evolvereaustralia/mini-dash/hardware/datasheets/waveshare-4.3c/display-back-photo-2026-11-09.png

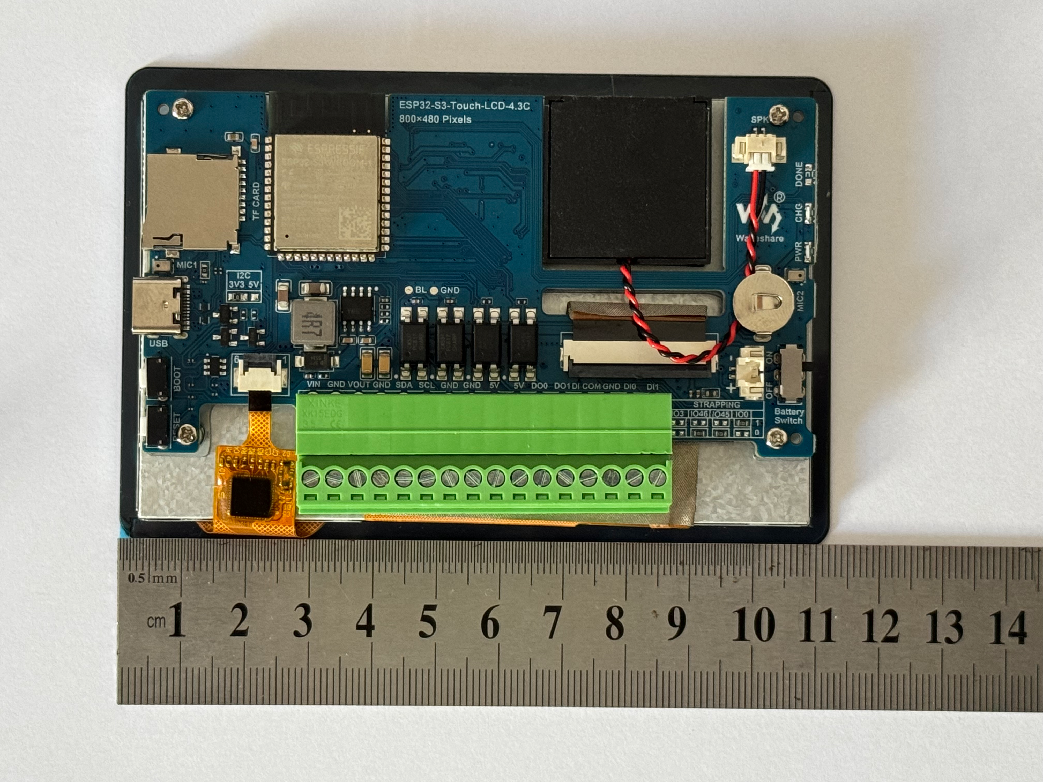
hardware/datasheets/waveshare-4.3c/display-back-photo-2026-11-09.png
