evolvereaustralia/mini-dash/hardware/enclosure/display-back-layout-check.png

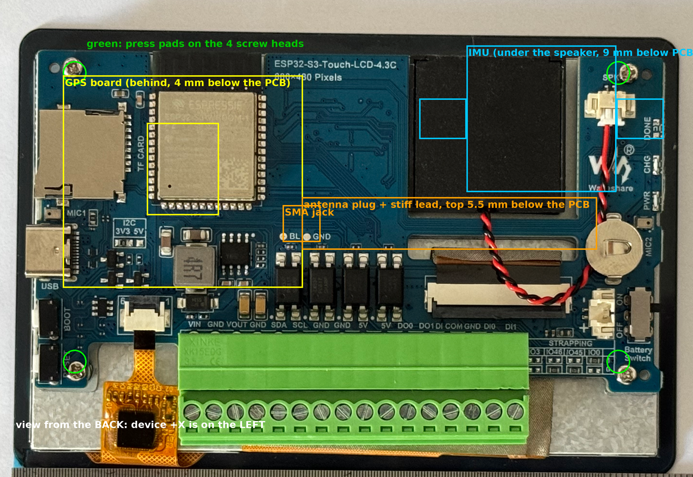
hardware/enclosure/display-back-layout-check.png
