evolvereaustralia/mini-dash/hardware/enclosure/mini-dash-layout-1-tray.png

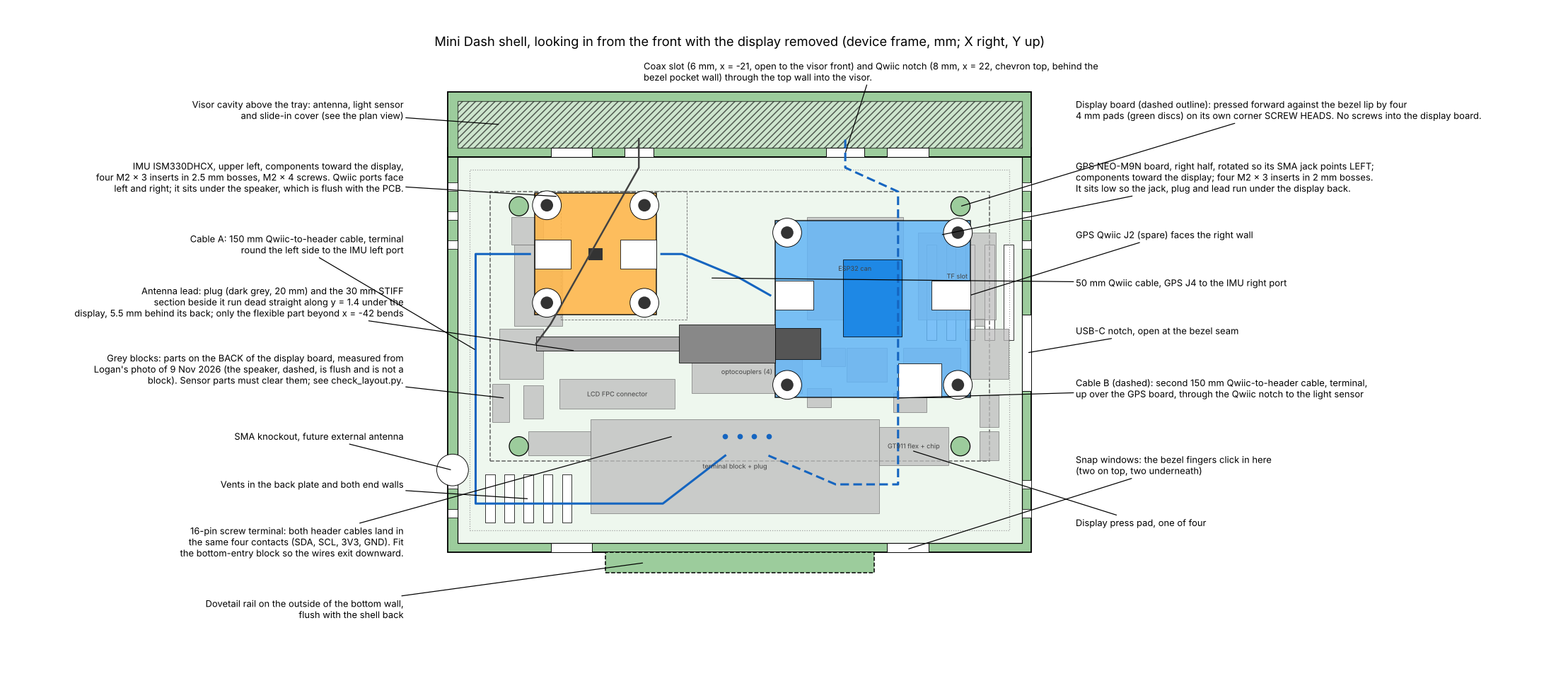
hardware/enclosure/mini-dash-layout-1-tray.png
