evolvereaustralia/mini-dash/hardware/enclosure/mini-dash-layout-2-visor.png

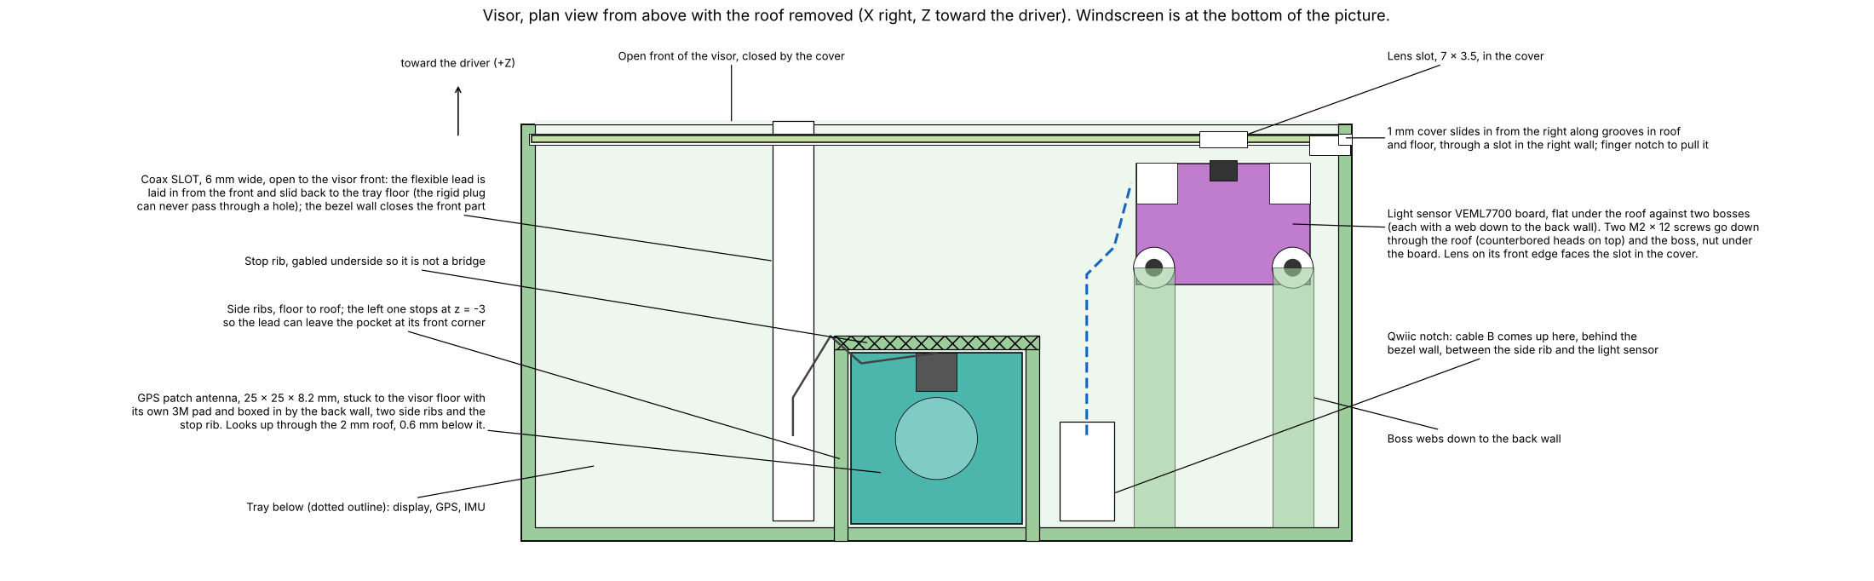
hardware/enclosure/mini-dash-layout-2-visor.png
