evolvereaustralia/mini-dash/hardware/enclosure/mini-dash-layout-3-sections.png

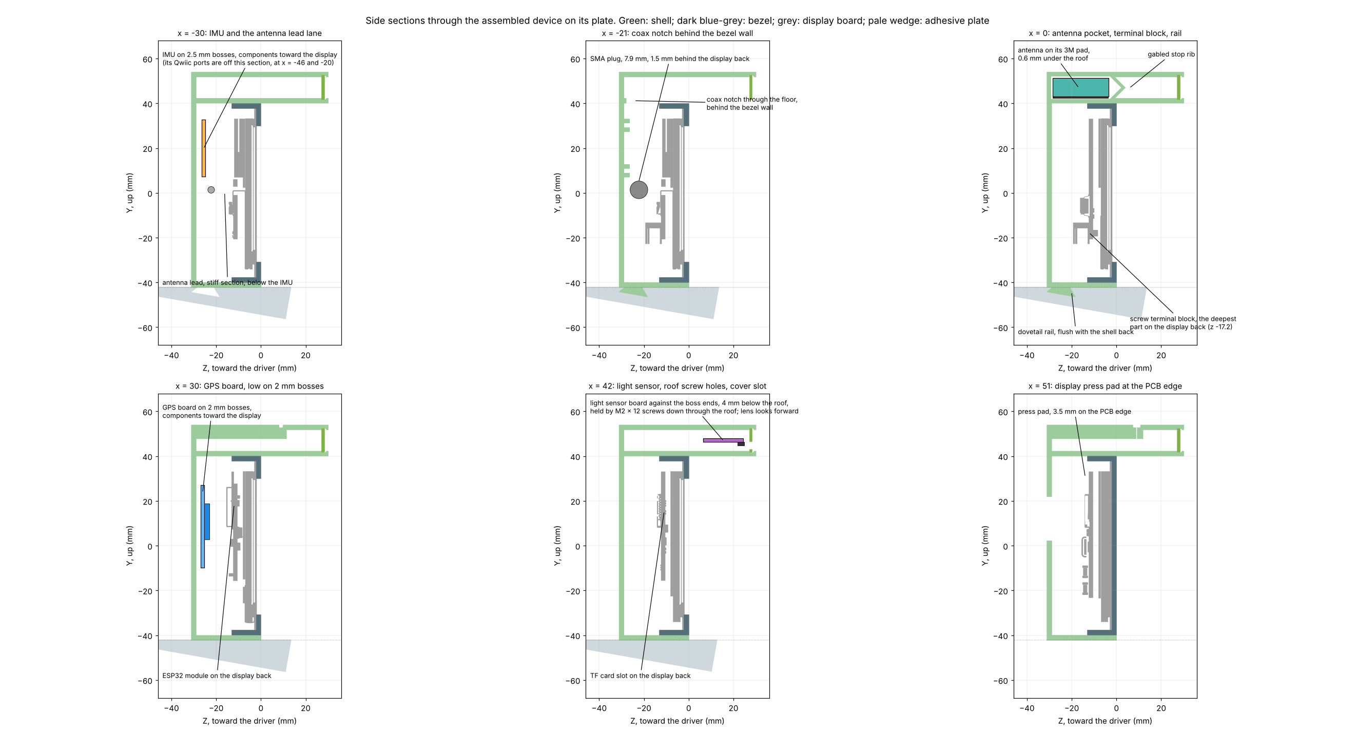
hardware/enclosure/mini-dash-layout-3-sections.png
