evolvereaustralia/mini-dash/hardware/enclosure/mini-dash-layout-4-exploded.png

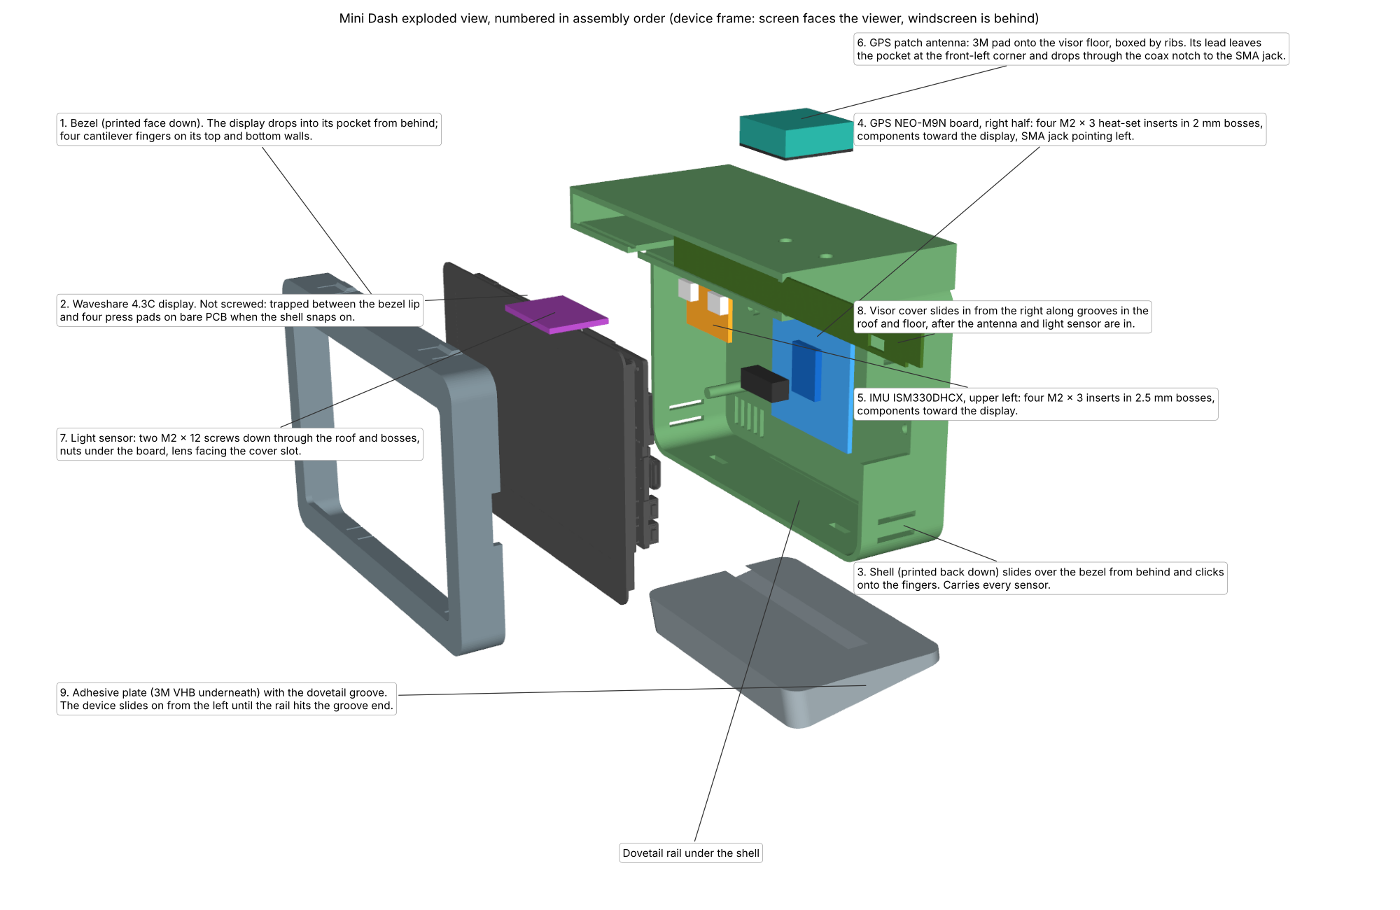
hardware/enclosure/mini-dash-layout-4-exploded.png
