evolvereaustralia/mini-dash/docs/bom.md

# Bill of materials

Status as of 24 Oct 2026. Prices AUD where known. Core Electronics unless noted.

| Item | Part | Qty | Status |
|---|---|---|---|
| Main board | Waveshare ESP32-S3-Touch-LCD-4.3C, standard, SKU 33799 | 1 | in hand |
| GPS | SparkFun GPS Breakout NEO-M9N, SMA, Qwiic (GPS-17285) | 1 | in hand |
| GPS antenna | SparkFun Antenna GPS Embedded SMA (GPS-00177) | 1 | in hand |
| IMU | SparkFun 6DoF IMU ISM330DHCX, Qwiic, 1 x 1 inch (SEN-19764) | 1 | in hand |
| Light sensor | Adafruit Right Angle VEML7700, STEMMA QT (ADA5378) | 1 | in hand |
| Qwiic cables 50 mm | Adafruit ADA4399 | 3 (1 used, 2 spare) | in hand |
| Qwiic to male header, 150 mm | Adafruit ADA4209 | 2 (1 in hand) | 2 more in the Core Electronics cart (one spare), $3.90 |
| Heat-set insert kit | Core Electronics CE10192 (M2 to M6; M2 x 3 on the GPS and IMU, 8 off) | 1 | in hand |
| Screws | Hilitchi 250-piece M2 stainless hex socket button head kit (8 x M2 x 4 for GPS and IMU, 2 x M2 x 12 plus 2 nuts for the light sensor) | 1 kit | in the Amazon AU cart, $22.99 |
| OBD dongle | Vgate vLinker BM+ BLE 4.0 (Amazon AU B08BR4KY1G) | 1 | ordered 21 Oct 2026 |
| USB-C cable | UGREEN 60 W USB-C to USB-C right angle, 1 m, USB 2.0 data | 1 | in the Amazon AU cart, $12.99 |
| Dash adhesive | Genuine 3M Scotch 5952 VHB, 12 mm x 4.5 m, black | 1 | in the Amazon AU cart, $31.20 (ships from Amazon US). Test patch first; 3M 4298 promoter only if the test fails |
| Filament | Prusament PETG (or ASA), about 150 g for all four parts | | in hand |
| Fallback power | 12 V socket USB-C PD adapter, 3 A | 1 | only if the car's port sags |
