evolvereaustralia/mini-dash/hardware/enclosure/export/mini-dash-assembly.step

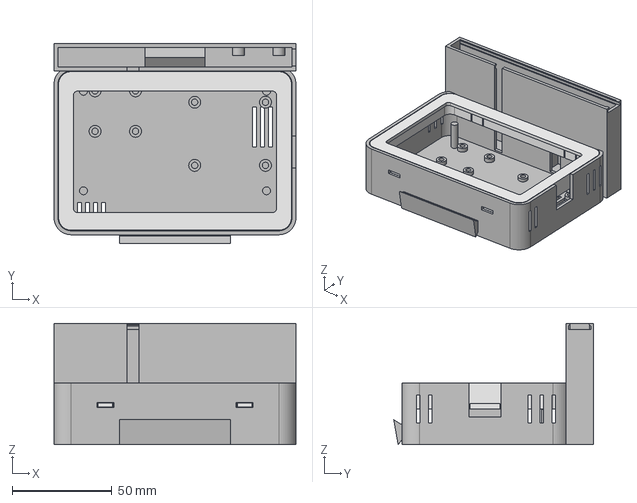
[picture p7: CAD file, 2026-11-09]
hardware/enclosure/export/mini-dash-assembly.step
121.6 x 100.3 x 61.0 mm
bezel
