evolvereaustralia/mini-dash/hardware/datasheets/ESP32-S3-Touch-LCD-4.3C-3D.stp

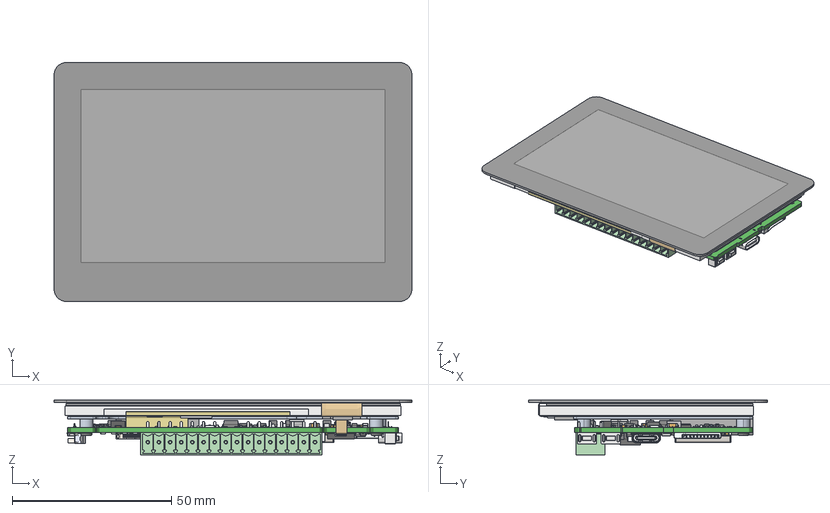
[picture p8: CAD file, 2026-10-24]
hardware/datasheets/ESP32-S3-Touch-LCD-4.3C-3D.stp
112.4 x 75.1 x 17.2 mm
SPK-26X26X4_2
BOARD
SOD323 x 3
_2_1_2_3_4_AF0 x 20
_7_1_2_AF0 x 20
5_1_2_A x 40
_7_AF0 x 40
USER_LIBRARY-RES_0603-0201_1 x 32
USER_LIBRARY-RES_0603-0201_2 x 32
USER_LIBRARY-RES_0603-0201_3 x 32
USER_LIBRARY-RES_0603-0201_4 x 32
FILTER-SMD_4P-L5_0-W4_5-BL_FI_1
FILTER-SMD_4P-L5_0-W4_5-BL_FI_2
3_1_2_3_A x 8
3_1_A x 22
3_1_2_A x 23
SOT-23 x 8
SMA-5401_AF0 x 7
SOT23-5AND6_00 x 10
SOT23-5-14065_AF0 x 2
EXTRUDED-426088
EXTRUDED-426483
EXTRUDED-427438
USER_LIBRARY-0201_0603M__CAP_1 x 81
USER_LIBRARY-0201_0603M__CAP_2 x 81
USER_LIBRARY-0201_0603M__CAP_3 x 81
EXTRUDED-442852 x 3
USER_LIBRARY-SOIC-8-150_PIN_SOI x 16
USER_LIBRARY-SOIC-8-150_SOIC_15 x 2
C0201_20210301_STEP_C0201_20210 x 14
L0201_20210301_STEP_L0201_20210 x 3
C0402_20210301_STEP_C0402_20210
R0201_20210301_STEP_R0201_202_1 x 8
R0201_20210301_STEP_R0201_202_2 x 8
R0201_20210301_STEP_R0201_202_3 x 8
TRACE_1_SUBMODEL-MINI-ANT-TYPEB
DFN1006_STEP_DFN1006_STEP_SUBMO
SOP8_REV1_20210308_STEP_SOP8_RE
XTAL3225_20210301_STEP_XTAL32_1
XTAL3225_20210301_STEP_XTAL32_2
XTAL3225_20210301_STEP_XTAL32_3
XTAL3225_20210301_STEP_XTAL32_4
XTAL3225_20210301_STEP_XTAL32_5
ESP32-S3_20210301_STEP_ESP32-_1
ESP32-S3_20210301_STEP_ESP32-_2
UID__4-128_DESIGNROOTMODEL_PCB_
UID__4-129_DESIGNROOTMODEL_PCB_
UID__4-130_DESIGNROOTMODEL_PCB_
UID__4-149_DESIGNROOTMODEL_PCB_
UID__4-150_DESIGNROOTMODEL_PCB_
UID__4-151_DESIGNROOTMODEL_PCB_
UID__4-167_DESIGNROOTMODEL_PCB_
UID__4-168_DESIGNROOTMODEL_PCB_
UID__4-169_DESIGNROOTMODEL_PCB_
UID__1-279_DESIGNROOTMODEL_PCB_
UID__1-280_DESIGNROOTMODEL_PCB_
UID__1-292_DESIGNROOTMODEL_PCB_
UID__1-298_DESIGNROOTMODEL_PCB_
UID__1-299_DESIGNROOTMODEL_PCB_
UID__1-300_DESIGNROOTMODEL_PCB_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
