evolvereaustralia/mini-dash/hardware/enclosure/export/mini-dash-shell.stl

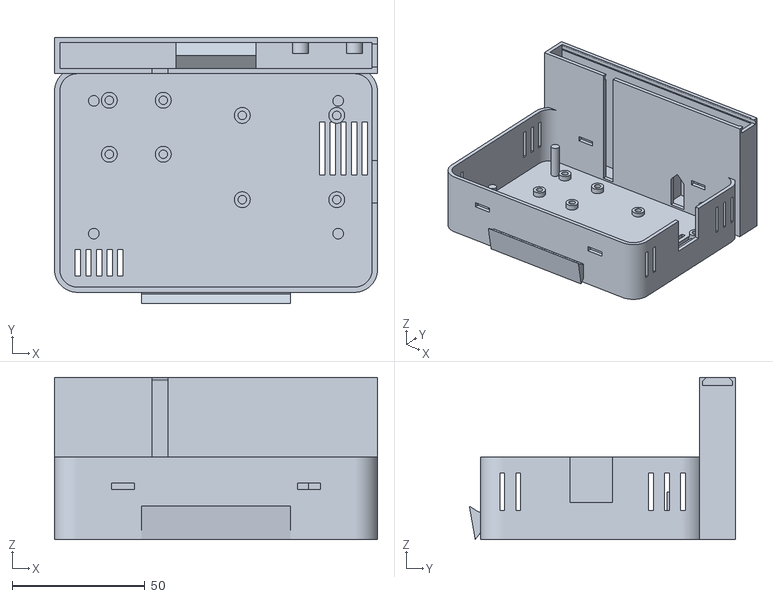
[picture p9: CAD file, 2026-11-09]
hardware/enclosure/export/mini-dash-shell.stl
121.6 x 100.3 x 61.0
