evolvereaustralia/mini-dash/hardware/enclosure/export/mini-dash-pad-coupon.stl

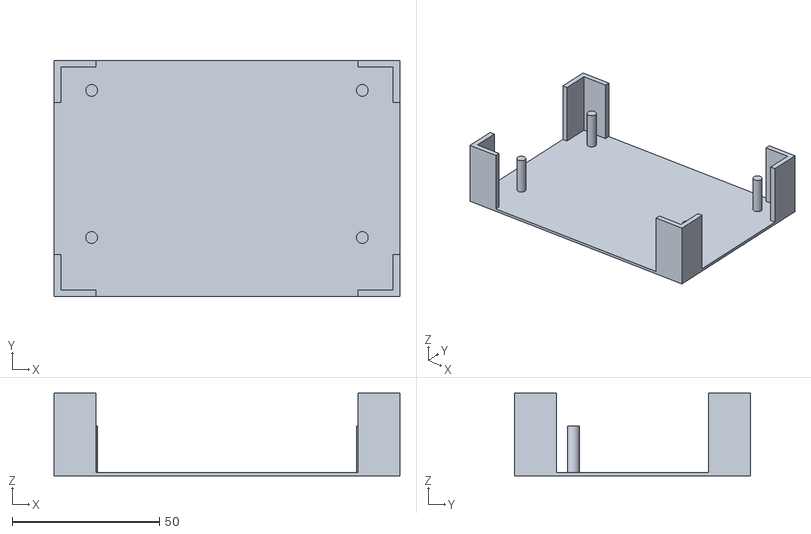
[picture p10: CAD file, 2026-11-08]
hardware/enclosure/export/mini-dash-pad-coupon.stl
117.6 x 80.3 x 28.2
