evolvereaustralia/mini-dash/hardware/enclosure/export/mini-dash-bezel.stl

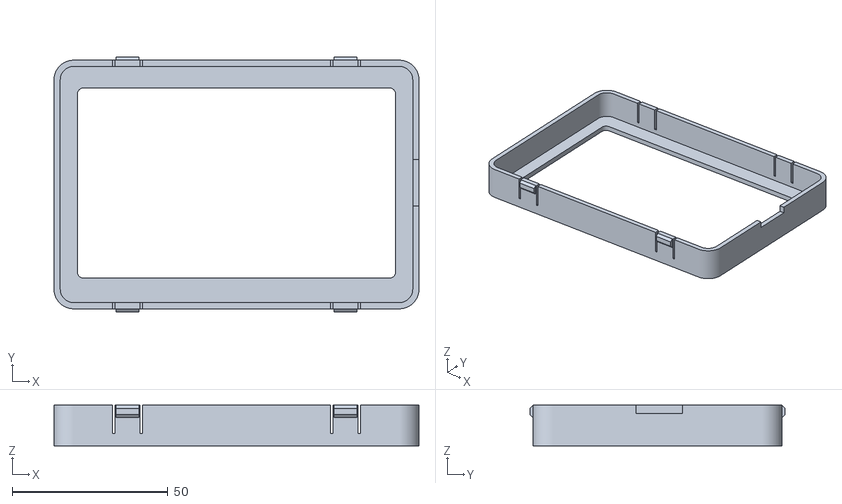
[picture p11: CAD file, 2026-11-08]
hardware/enclosure/export/mini-dash-bezel.stl
117.0 x 81.7 x 13.0
