evolvereaustralia/mini-dash/hardware/enclosure/export/mini-dash-insert-coupon.stl

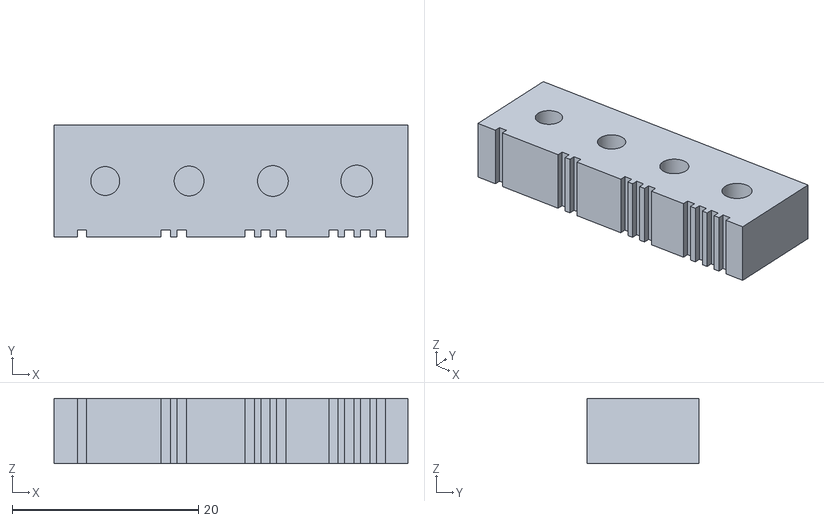
[picture p12: CAD file, 2026-10-25]
hardware/enclosure/export/mini-dash-insert-coupon.stl
38.0 x 12.0 x 7.00
