evolvereaustralia/mini-dash/hardware/enclosure/export/mini-dash-visor-cover.stl

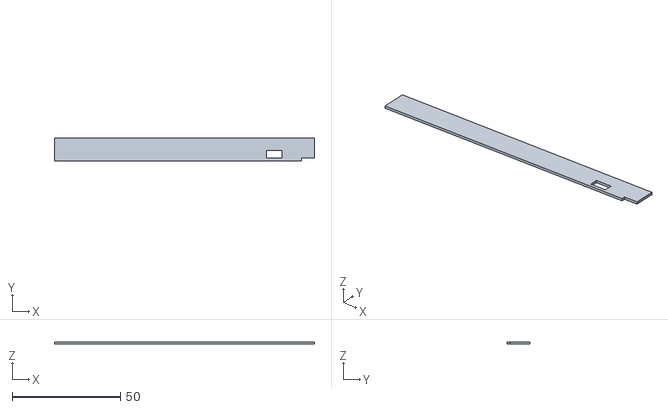
[picture p13: CAD file, 2026-10-24]
hardware/enclosure/export/mini-dash-visor-cover.stl
119.9 x 10.7 x 1.00
