evolvereaustralia/mini-dash/hardware/enclosure/export/mini-dash-plate.stl

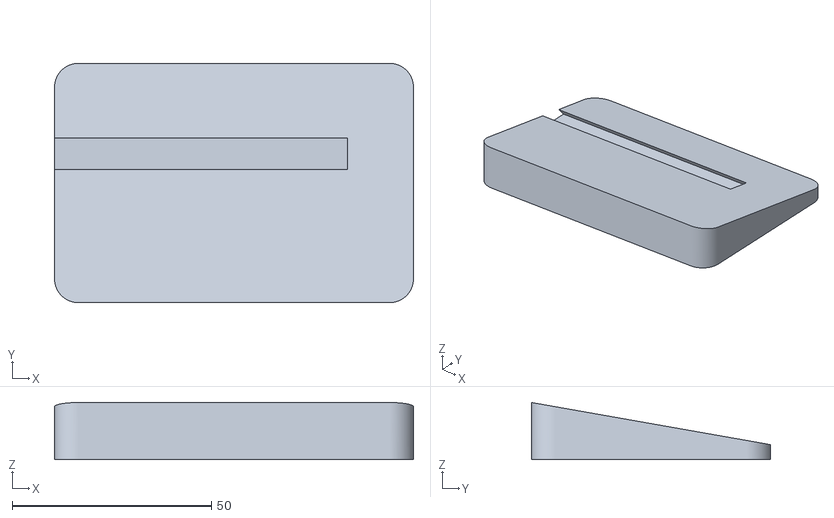
[picture p14: CAD file, 2026-10-24]
hardware/enclosure/export/mini-dash-plate.stl
90.0 x 60.0 x 14.3
