evolvereaustralia/mini-dash/(list of files, cad)

Other CAD files:
hardware/datasheets/waveshare-4.3c/ESP32-S3-Touch-LCD-4.3C-2D.dxf
