evolvereaustralia/mini-dash/docs/calibration.md

# Calibration

To be written in phase 3b. Will cover: IMU mounting calibration in Settings (stationary, level road, engine off), accelerometer bias at standstill, checking the attitude estimate against a hard stop, and the GPS speed cross-check against the speedo.
