evolvereaustralia/mini-dash/(commit log)

2026-10-24 Mini Dash: brief v2, enclosure draft 2.5, printability checker, layout drawings, datasheets
    Repo set-up for phase 2. CLAUDE.md is the single source of truth. Enclosure
    model (CadQuery) with rail-on-shell dovetail, layer-by-layer overhang check,
    four layout drawings generated from the model and Waveshare's STEP, STL/STEP
    exports, and the Waveshare and SparkFun board files the design was measured
    from. Firmware starts in phase 3a.
    Claude-Session: https://claude.ai/code/session_01TbvJXnNUeiEdX23skT3Aox
2026-10-24 BOM and adhesive: dongle already ordered, 3M VHB 5952 for the plate, carts built
    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
2026-10-24 Test log: VOUT 3.43 V pass, header cable A wired
    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
2026-10-25 Insert test coupon STL and heat-set procedure in assembly notes
    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
2026-11-05 Enclosure draft 2.6: notches behind the bezel wall, GPS right and rotated, press pads on bare PCB, roof screws for the light sensor
    - Both floor notches moved to z -22..-13.5, behind the bezel pocket wall; coax notch 10 mm at x -21, Qwiic 8 mm at x 22
    - GPS board right half, rotated 180 (SMA jack left), 2 mm bosses with M2 x 3 inserts; plug plus 30 mm stiff lead run straight along y = 4 under bare PCB
    - IMU to (-33, 22); left antenna rib stops at z -3 so the lead leaves the pocket at the front corner
    - Display bosses replaced by four 5 mm press pads on bare PCB (old ones sat on the DC terminal and standoffs, display was off-centre)
    - Light sensor: M2 x 12 through counterbored roof holes, nut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
2026-11-08 Enclosure draft 2.7: fix the 2 mm glass datum, relayout for the corrected depth
    - Device z = 0 is the bezel front face; the glass sits at -2 and the PCB back at -12.2 (PCB_BACK_Z). Drafts to 2.6 placed the display 2 mm too far forward, so the 2.6 bezel stood 2 mm proud with only the display fitted
    - Press pads now reach -12.2; USB-C notch heights corrected
    - SMA plug (7.9) cannot fit under the PCB in 10.8 mm: GPS board to the left half, unrotated, jack pointing right, plug and stiff lead along y 37.2 in the band above the PCB edge
    - IMU to (41, 6) under the TF slot, rotated 90 (ports up and down), 2.5 mm bosses; M2 x 3 inserts and M2 x 4 screws for both boards
    - Coax notch x 21, Qwiic notch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
2026-11-08 assembly: Qwiic notch is at x = 40
    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
2026-11-08 Pad test coupon: four press pads and glass-datum posts on a thin plate
    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
2026-11-08 Enclosure draft 2.8: glass datum fixed, shell 2 mm deeper, 2.6 layout kept; pad test coupon
    - Device z = 0 is the bezel face; PCB back at -12.2 (PCB_BACK_Z). Press pads now reach it; USB-C notch heights corrected
    - DEPTH 25 -> 27 so the 2.6 layout is unchanged relative to the display back; SMA plug keeps 1.5 mm under the PCB
    - 2.7 (plug beside the PCB) withdrawn: the tray is 80.3 inside, not 97
    - Clearances re-run with the true walls; layer check unchanged; drawings regenerated
    - pad_coupon.py: pads and glass-datum posts on a thin plate for a half-hour check before the shell print
    - GPS screws M2 x 4; CLAUDE.md, decisions, assembly, BOM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
2026-11-08 assembly: coupon file name
    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
2026-11-08 Enclosure draft 2.9: pads on the corner screw heads, DEPTH 31, coax slot open to the visor front; display back photo as the reference
    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
2026-11-09 Draft 2.9 final: GPS (48, 27), IMU (-30, 20) on 2.5 mm bosses; photo-derived part list and check_layout.py; coupon pass logged
    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
